AlainaWayne/AutoFeeder/README.md

# Smart Refridgerated Pet Feeder

![insert demo gif]()

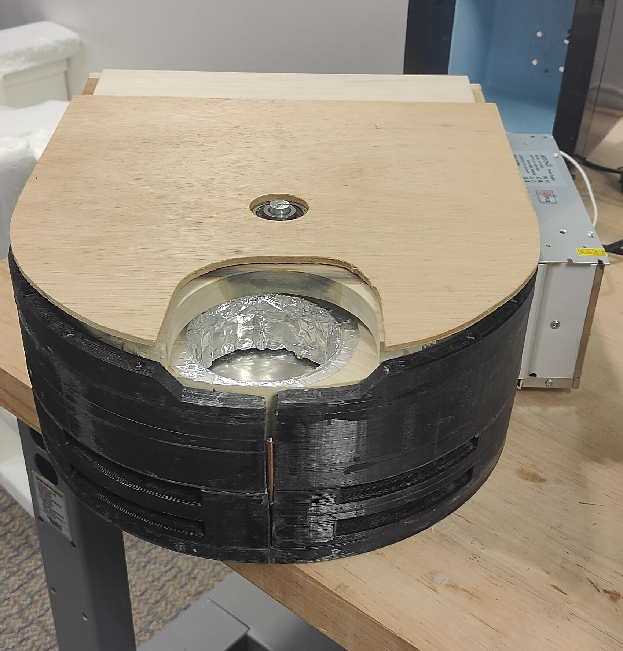
[picture p1: final_assembly_external.jpg]
Project External

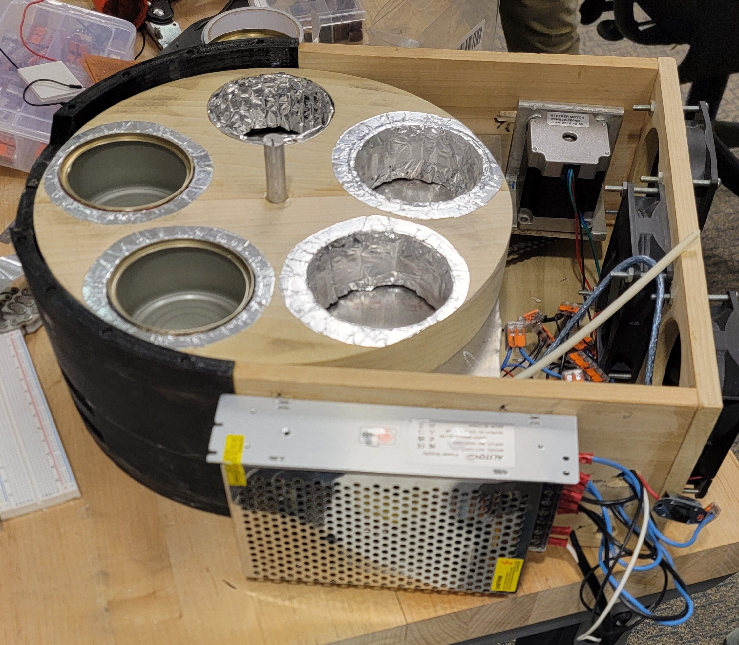
[picture p2: final_assembly_internal.jpg]
Project Internal


## Overview

The Automatic Wet Food Cat Feeder is an innovative solution to address the challenges of feeding cats on a wet food diet while the owner is away. It ensures precise portioning, maintains food freshness, and automates feeding schedules to provide convenience for pet owners and quality care for their pets.

This project was developed as part of the MECH 495 Senior Design Capstone at Kettering University.

---

## Features

- **Effective Cooling:** Maintains low temperatures to preserve wet food safety and quality
- **Accurate Dispensing:** Ensures precise rotation to dispense one portion of food at a time
- **User-Friendly Design:** Simple operation with easy refills and cleaning
- **Compact & Aesthetic:** Space-efficient and visually appealing design
- **Durable Construction:** Food-safe materials ensure long-term usability
- **Thermal Efficiency:** Isolates hot and cold zones for effective cooling
- **Cost Effective:** Designed to minimize costs
- **Future Expandability:** Designed to accommodate potential smart features

---

## Components & Materials

| Component | Quantity | Description |
|---|---|---|
| 3.5-in Fans | 3 pcs | Cooling airflow |
| Peltier Devices | 4 pcs | Thermoelectric coolers |
| Heat Sinks | 4 pcs | Heat dissipation |
| Arduino Uno Controller| 1 pc | Microcontroller |
| TB6600 Stepper Motor Driver | 1 pc | Motor control |
| Stepper Motor | 1 pc | Rotational motion |

For the complete Bill of Materials, refer to the [BOM File](https://github.com/AlainaWayne/AutomatedWetFoodFeeder/blob/main/Bill%20of%20Materials).

---

## Design Goals

1. **Reliability:** Ensures consistent feeding schedules.
2. **Power Efficiency:** Optimized for minimal power draw.
3. **Safety:** Designed with pet safety in mind.
4. **Ease of Maintenance:** Simple to disassemble for cleaning.
5. **Sustainability:** Incorporates recycled and repurposed components.

CAD Model

---

## Manufacturing Process

The feeder was crafted using a combination of CNC machining, 3D printing, and traditional woodshop techniques. Custom components were fabricated with 3D printing and aluminum sheet metal for the cooling system.

### Turntable
cat feeder turntable dimensional drawing
- The turntable was designed to hold 4 full cat food cans (enough food for 2-4 days depending on feeding schedule)
- there is an empty slot to be used as a home position when the machine is not in use

- The turntable needed to be 12 inches in diameter, but the largest stock wood we had access to was 8 inches wide
- To solve this we glued together two pices of stock material to be cut on the CNC mill

Turntable Milling
- It was milled on a Laguna IQ CNC machine

Turntable milling issue
- The stock material ended up being slightly thicker than what we designed for, so th emachine did not cut the holes all the way through
- To fix this, a hand saw was used to cut the rest of the way

Turntable

### Main Housing
- The main housing of the feeder was designed to accomodate electrical components while balancing providing sufficient insulation to keep food cold as well as evacuating heat from the hot side of the Peltier modules

#### Back Shell
- The main function of the back shell is to house the electrical components and provide a route for heat to be pulled from the system

cat feeder shell dimensional drawing
- This section of the housing was manufactured using a combination of machine tools and hand tools

- First, each panel of wood (base, 2 side walls, and back wall) we cut to the correct dimensionsions using a miter saw
- The back wall panel then had 3 circular holes, where the fans would later be attached, carefully cut out using a drill press with a hole saw attachment
- 
- 
  
- once each panel was cut, aditinal sanding using rotary, belt, and random orbital sandering tools was done to ensure that the wood was consistently smooth and minimize risk of splintering

gluing housing components
- The panels were then initially glued together using wood glue to privide strength and stability for installing wood screws

assembled wood components and fans

#### 3D Printed Air Intake Section

- The front section was designed to be 13 inches wide with symmetrical vent slots for air intake
- Due to bed size limitations of the Ender 3 Pro, the model was cut in half to be printed in two sections
- We chose to use PETG filament for its strength and thermal properites
- Each print was estimated to take about 12 hours (24 hours total) using an 8 mm nozzle

#### Lid
CNC Lid
lid assembly
fixed lid assembly
fully asseblmed lid
  
---

#### Sliding Motor Tensioning
motor tensioning
- During assembly, an issue was encountered where the motor would shift and cause the chain to loose tension over time
- This was resolved by implementing a sliding tensioning system
## Electronics

main arduino connection scematics
motor scematics
peltier scematics
hall sensor scematics

---
## Software

The plan for the code is relatively simple. Below is an outline of its structure and functionality:

### Overview

- **Constants and Variables:** All constants and variables are declared at the start to avoid confusion later.
- **Setup Routine:** All pin modes are configured in the startup routine.
- **State Machine:** The main logic is controlled by a state machine with four states:

### States

1. **WaitHome:**
   - The feeder is at the “home” position (food is not available).
   - In this state, the machine waits for input (a button in demo mode, or a timed schedule in real operation).
   - When input is received, the state transitions to `MoveFeed`.

2. **MoveFeed:**
   - The feeder moves to the next available can.
   - **Logic:**
     - Tracks which cans have been used.
     - Moves in the rotation that is fastest to reach the next available can.
   - **Tracking:**
     - Uses magnets and 2 hall effect sensors as an encoder to detect direction and position changes.
   - Once the desired can is reached, the state transitions to `WaitFeed`.

3. **WaitFeed:**
   - This state is similar to `WaitHome`.
   - The machine waits for input to indicate feeding is complete.
   - When input is received, the state transitions to `MoveHome`.

4. **MoveHome:**
   - The feeder returns to the “home” position.
   - **Logic:**
     - The current location is compared to the home position.
     - Rotates in the faster direction to return home.
   - **Tracking:**
     - An offset hall effect sensor detects a specific magnet placed at the home position.
     - When the sensor detects this magnet, the machine confirms it is in the “home” position.
   - Once home, the state transitions back to `WaitHome`.

### Summary

This state machine design ensures clear and predictable operation, handling both user input and positional accuracy.

[Link to Code](https://github.com/AlainaWayne/AutomatedWetFoodFeeder/blob/b0ec120aadc8a26be4aa09604b9c6fafe7771586/feeder_control/feeder_control.ino)

---

## Testing & Validation

### Key Tests
- **Cooling Performance:** Tested cooling rate of Peltier devices in pre-built fridge.
- **Motor Selection:** Torque calculations ensured sufficient rotation force.
- **Usability Testing:** Identified optimal height of 8 inches for maximum cat comfort.

### Results
- Cooling system reduced temperatures by 34°F over 3 hours.
- Stepper motor met torque requirements with a significant safety margin.

---

## Challenges & Solutions

- **Dimensional Adjustments:** CNC panel inaccuracies were resolved with manual corrections
- **3D Printing Challenges:** Due to 3D printer limitations, 3D printed components needed significant post-processing in order to fit properly with design
- **Chain Tensioning:** Improved by modifying motor mounting to allow tension adjustments

---

## Future Improvements

- Enhanced power efficiency
- Increased cooling capacity for prolonged food storage
- Smart integration for remote operation and monitoring
- Improved manufacturing of hardware components
- More testing is needed to determin reliablity of Peltier cooling and system operation

---

## Contributors

- Damera Gebissa
- Christian Pellerito
- Alaina Wayne
- Julia Carroll
- Jacob Morrison

---

## Acknowledgments

Special thanks to Dr. Craig Hoff and the Kettering University IME Lab for guidance and support!
