AlainaWayne/AutoFeeder/Deliverables/Bill of Materials - Pet Feeder Project (1).xlsx - Sheet1.pdf

Item | Description | Quantity | Unit Cost | Total Cost | Projected Cost Item Number | Source | Link
3.5-in Fans | Cooling Motor | 2 | $5.09 | $10.18 | $10.18 17545K63 | McMasterr-Carr https://www.mcmaster.com/catalog/130/759/17545K66 Peltier Device | Generate Power, Heating & Cooling | 4 | N/A | N/A | $86.08 9383N16 | McMasterr-Carr https://www.mcmaster.com/products/peltier-coolers/thermoelectric-modules~/ Heat Sinks | Cooling Peltier | 4 | $12.66 | $50.64 | $50.64 8822T949 | McMasterr-Carr https://www.mcmaster.com/products/heat-sinks/adhesive-mount-heat-sinks/ Wood | Frame of Turntable | 1in.x12in.x4ft. | N/A | N/A | $8.62 458503 | Home Depot | https://www.homedepot.com/p/1-in-x-12-in-x-4-ft-Pine-Common-Board-458503/100322335 Arduino Controller | Control Machine | 1 | N/A | N/A | $44.99 B01D8KOZF4 | Amazon | https://www.amazon.com/ELEGOO-Project-Tutorial-Controller-Projects/dp/B01D8KOZF4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 Motor Controller | Operate Motor | 1 | $15.95 | $15.95 | $15.95 2133 | Pololu | https://www.pololu.com/product/2133 Stepper Motor | Provide Energy | 1 | N/A | N/A | $11.00 17HS4401 | Alibaba | https://www.alibaba.com/product-detail/HANPOSE-17hs4401-1-5A-40N-cm_62449855694.html Assorted Wires | Transfer Electricity | Unknown | N/A | N/A | $5.97 | B0BRTJXND9 | Amazon | https://www.amazon.com/California-JOS-Breadboard-Optional-Multicolored/dp/B0BRTJXND9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 Assorted Foam Roll | Insulation | 6in.x550ft. | N/A | N/A | $23 S-2601 | ULINE | https://www.uline.com/BL_855/Uline-Non-Perforated-Foam-Rolls Silicon Seal | Seal | 4 | $5.83 | $23.32 | $14.72 92614 | US Plastics Co. https://www.usplastic.com/catalog/item.aspx?itemid=150353&catid=1427 RFID | Sensor | 1 | N/A | N/A | $10 CN0460 | Sunfounder | https://www.sunfounder.com/products/rfid-kit-blue Fridges | Take Peltier Components | 2 | $30 | $60 | $60 N/A | Marketplace | https://www.facebook.com/marketplace/item/2382667205407606/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 Thermalpaste | Glue High Temp Materials | 1 | $12.19 | $12.19 | $12.19 3715N11 | McMasterr-Carr https://www.mcmaster.com/catalog/130/4197/3715N11 Thermal Cutoff Switch | Turn off Heating Element | 1 | $24.59 | $24.59 | $24.59 3419N12 | McMasterr-Carr https://www.mcmaster.com/catalog/130/1169/3419N12 V-Belt | Run Turntable | 1 | $9.75 | $9.75 | $9.75 6191K16 | McMasterr-Carr https://www.mcmaster.com/products/belts/v-belts-2~/v-belts-8/ V-Belt Pulley | Run Turntable | 1 | $7.14 | $7.14 | $7.14 6245K312 | McMasterr-Carr https://www.mcmaster.com/products/belts/chain-and-belt-pulleys~/v-belt-pulleys-8/ V-Belt Pulley | Run Turntable | 1 | $9.14 | $9.14 | $9.14 6245K314 | McMasterr-Carr https://www.mcmaster.com/products/belts/chain-and-belt-pulleys~/v-belt-pulleys-8/ Dry-wall Insulation | Insulation | 1in.x4ft.x8ft. | N/A | N/A | $27.48 20WENGX | Home Depot | https://www.homedepot.com/p/Owens-Corning-FOAMULAR-NGX-F-150-1-in-x-4-ft-x-8-ft-SSE-R-5-XPS-Rigid-Foam-Board-Insulation-20WENGX/315197840 Spray foam insulation | Insulation | 16 sq. ft. | N/A | N/A | $8.40 8551K12 | McMasterr-Carr https://www.mcmaster.com/catalog/130/4049/8551K12
Items marked N/A are already owned, or being recycled from prior projects. | $222.90 | $439.74
