AlainaWayne/AutoFeeder/Manufacturing/20241104_153120.jpg

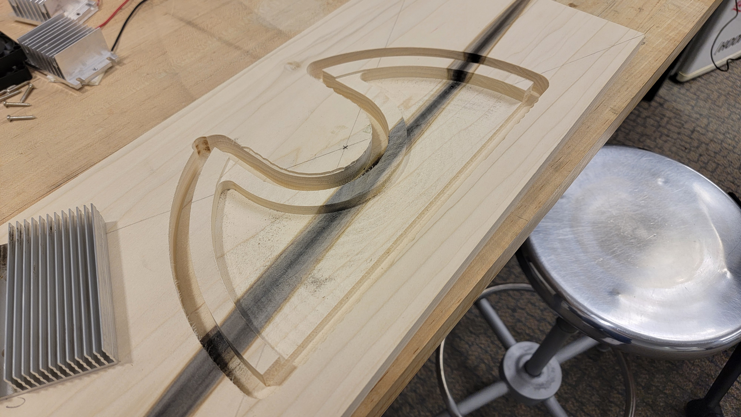
Manufacturing/20241104_153120.jpg
