AlainaWayne/AutoFeeder/Manufacturing/20241104_162909.jpg

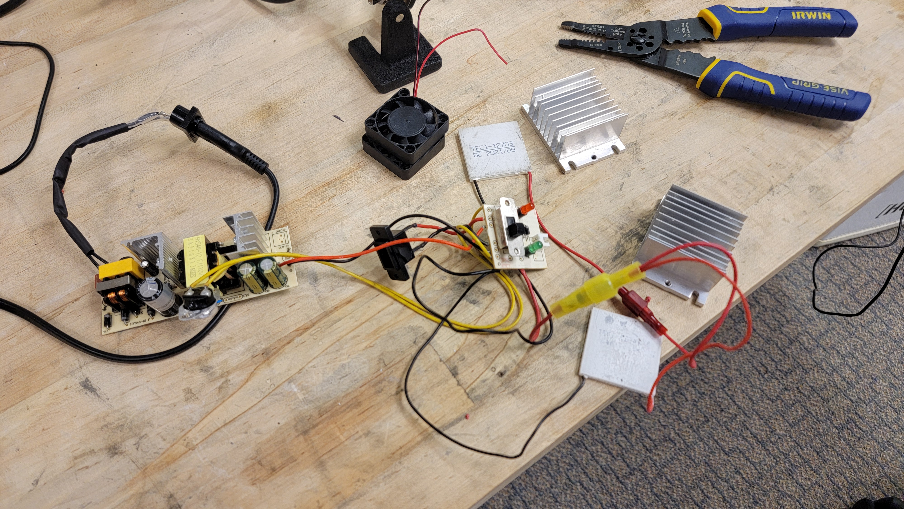
Manufacturing/20241104_162909.jpg
