AlainaWayne/AutoFeeder/Manufacturing/20241121_171549.jpg

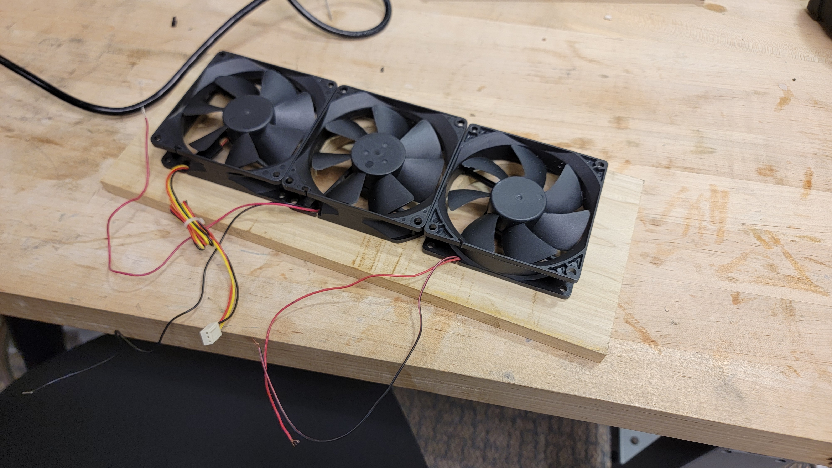
Manufacturing/20241121_171549.jpg
