AlainaWayne/AutoFeeder/Manufacturing/20241205_174115.jpg

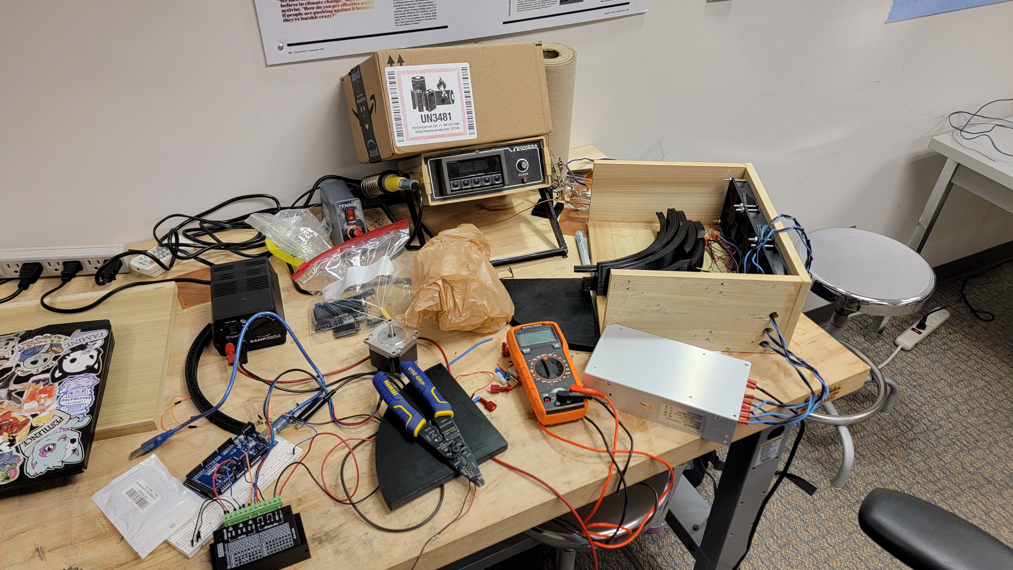
Manufacturing/20241205_174115.jpg
