AlainaWayne/AutoFeeder/Manufacturing/20241206_150830.jpg

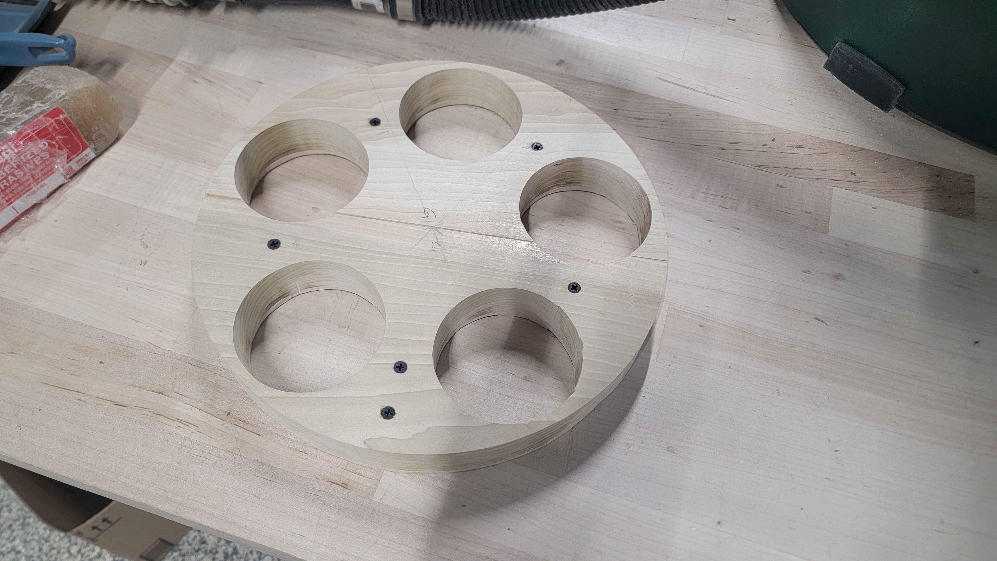
Manufacturing/20241206_150830.jpg
