AlainaWayne/AutoFeeder/Manufacturing/20241206_191830.jpg

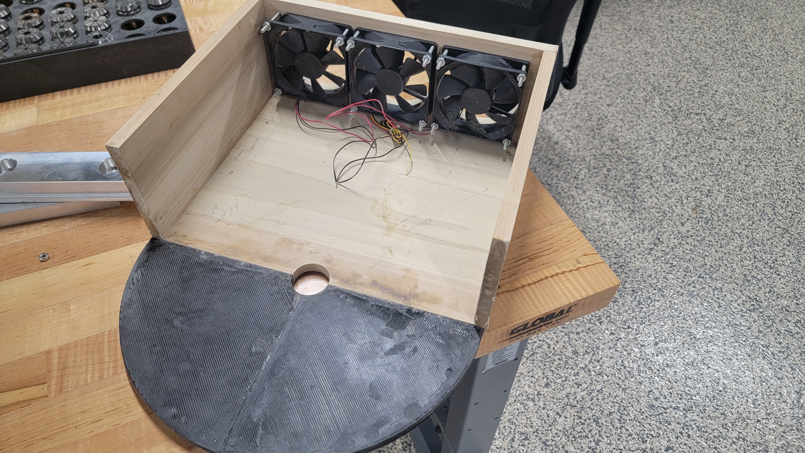
Manufacturing/20241206_191830.jpg
