AlainaWayne/AutoFeeder/Manufacturing/20241206_191835.jpg

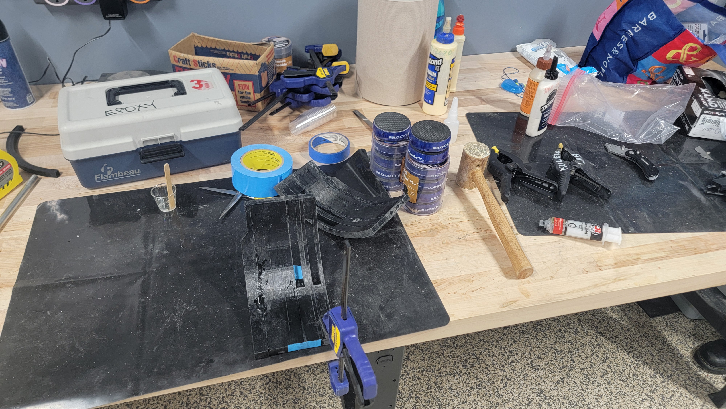
Manufacturing/20241206_191835.jpg
