AlainaWayne/AutoFeeder/Manufacturing/20241206_195926.jpg

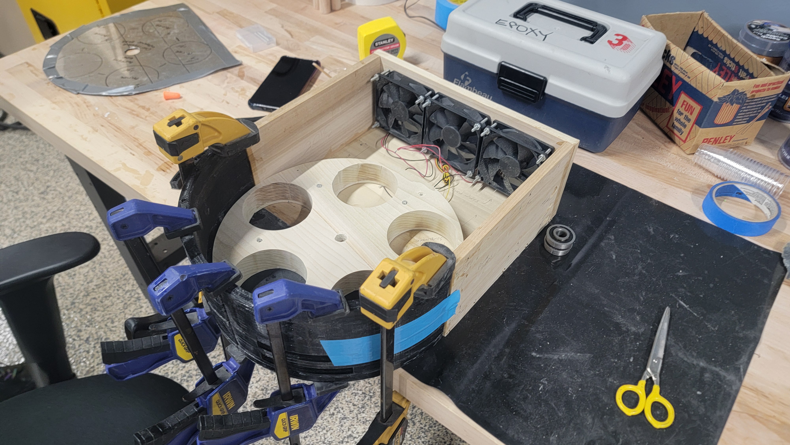
Manufacturing/20241206_195926.jpg
