AlainaWayne/AutoFeeder/Manufacturing/20241212_183925.jpg

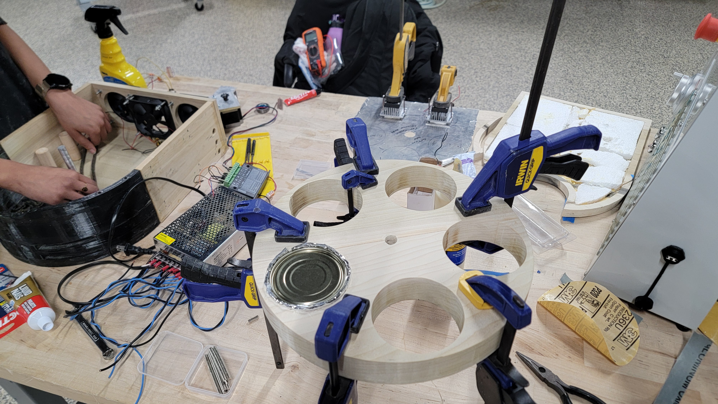
Manufacturing/20241212_183925.jpg
