AlainaWayne/AutoFeeder/Manufacturing/20241212_194303.jpg

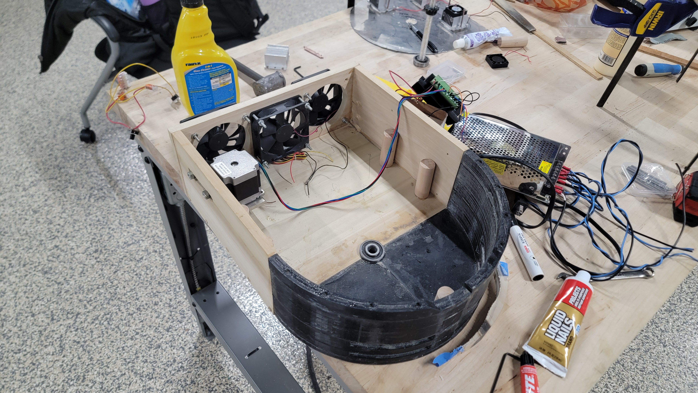
Manufacturing/20241212_194303.jpg
