AlainaWayne/AutoFeeder/Manufacturing/IMG20241106135203.jpg

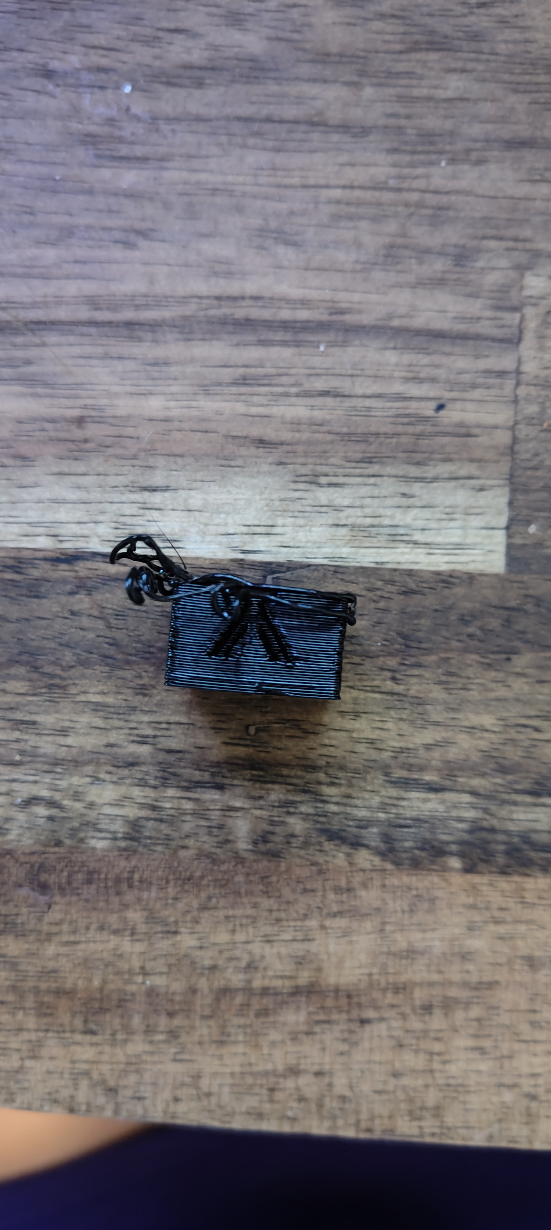
Manufacturing/IMG20241106135203.jpg
