AlainaWayne/AutoFeeder/Manufacturing/IMG20241106154316.jpg

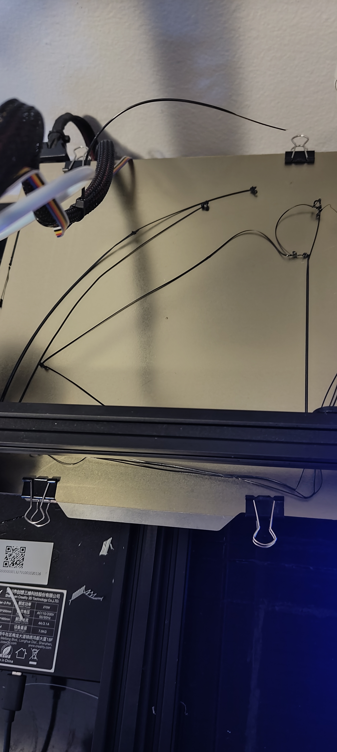
Manufacturing/IMG20241106154316.jpg
