AlainaWayne/AutoFeeder/Manufacturing/IMG20241106161655.jpg

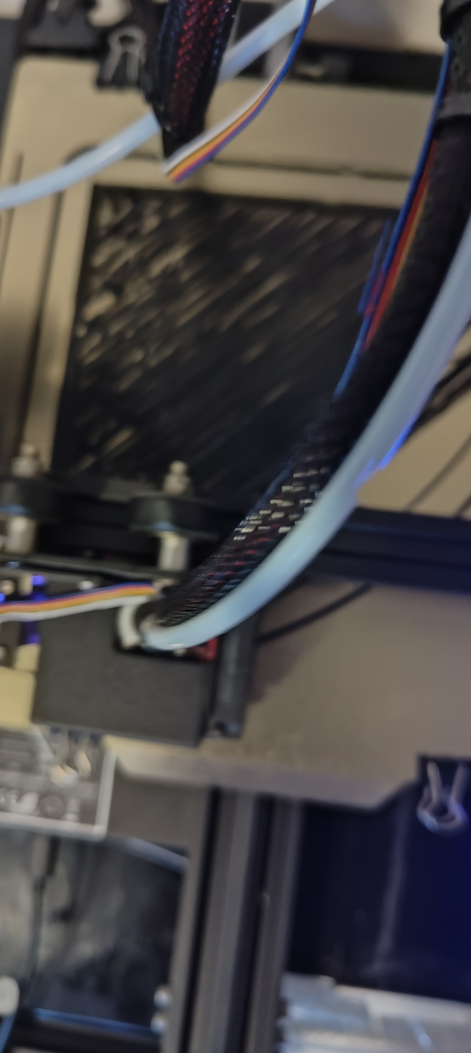
Manufacturing/IMG20241106161655.jpg
