AlainaWayne/AutoFeeder/Manufacturing/IMG20241106170730.jpg

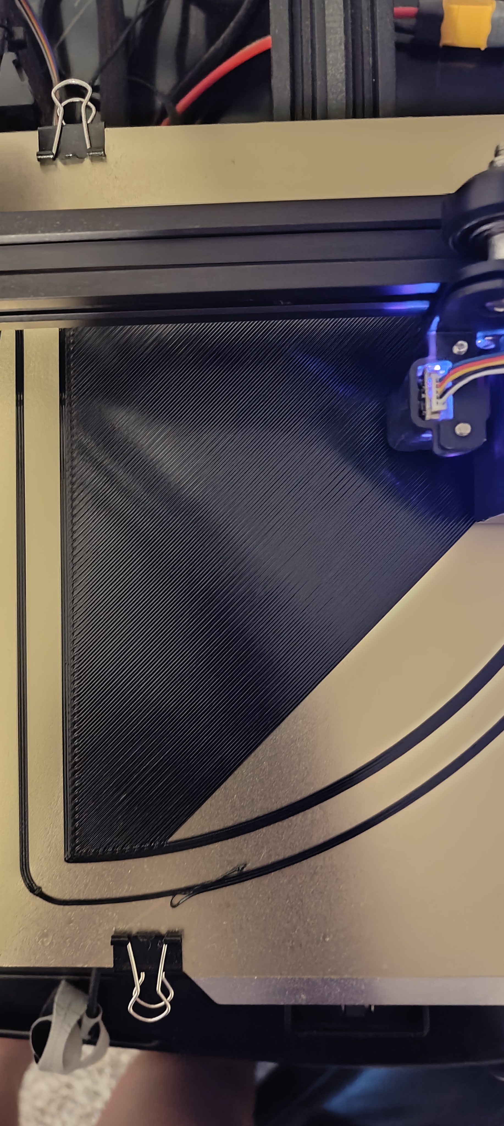
Manufacturing/IMG20241106170730.jpg
