AlainaWayne/AutoFeeder/Manufacturing/IMG20241107103250.jpg

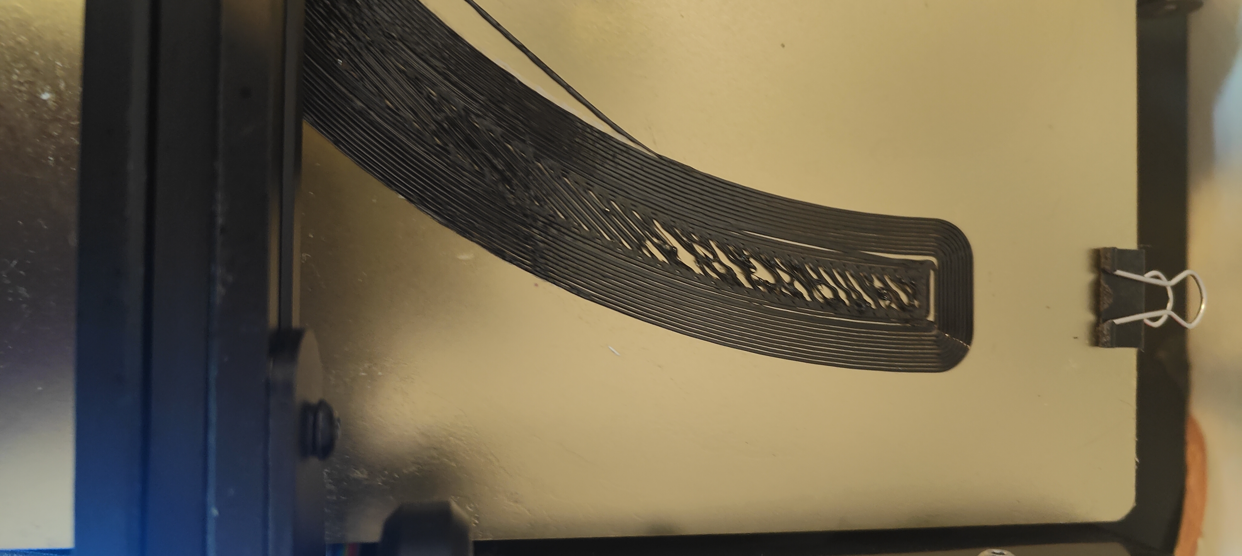
Manufacturing/IMG20241107103250.jpg
