AlainaWayne/AutoFeeder/Manufacturing/IMG20241129104141.jpg

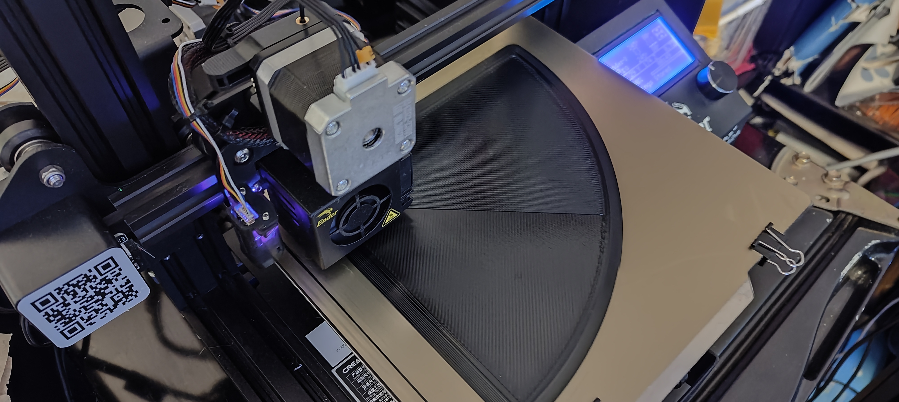
Manufacturing/IMG20241129104141.jpg
