AlainaWayne/AutoFeeder/Manufacturing/IMG20241129104142.jpg

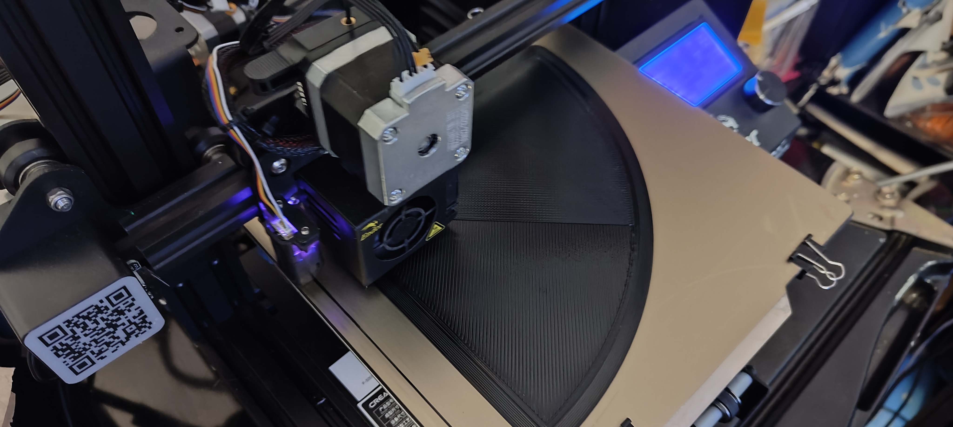
Manufacturing/IMG20241129104142.jpg
