AlainaWayne/AutoFeeder/Manufacturing/IMG20241129130520.jpg

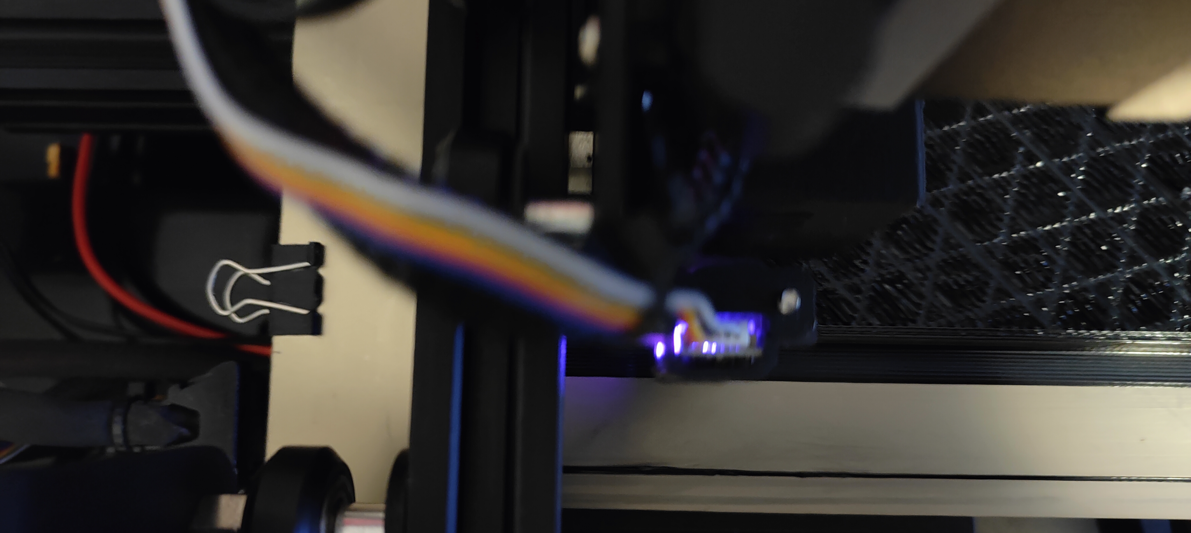
Manufacturing/IMG20241129130520.jpg
