AlainaWayne/AutoFeeder/Manufacturing/IMG20241129130526.jpg

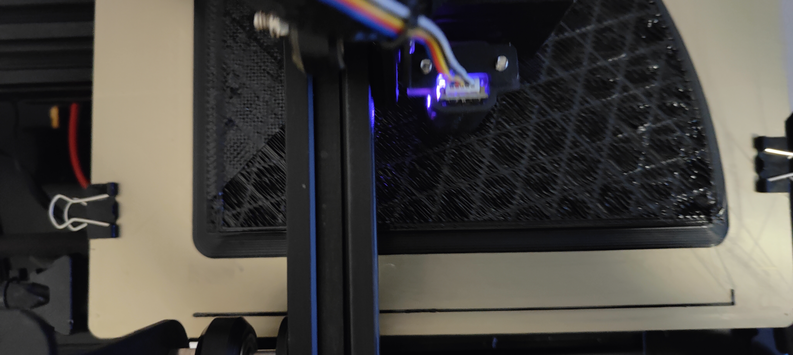
Manufacturing/IMG20241129130526.jpg
