AlainaWayne/AutoFeeder/Manufacturing/IMG20241129130749.jpg

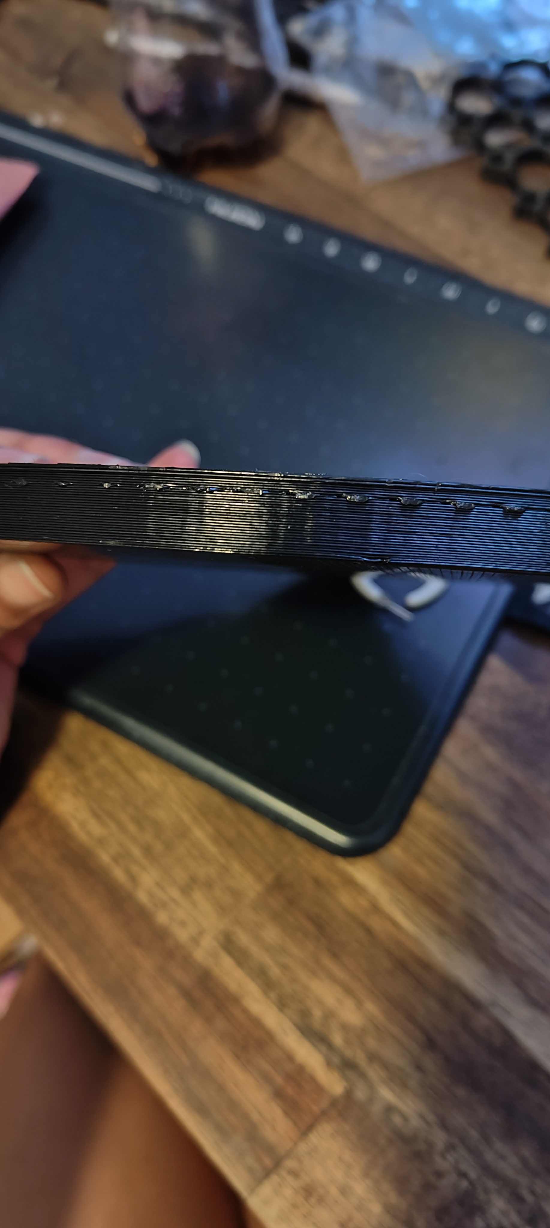
Manufacturing/IMG20241129130749.jpg
