AlainaWayne/AutoFeeder/Manufacturing/IMG20241129135219.jpg

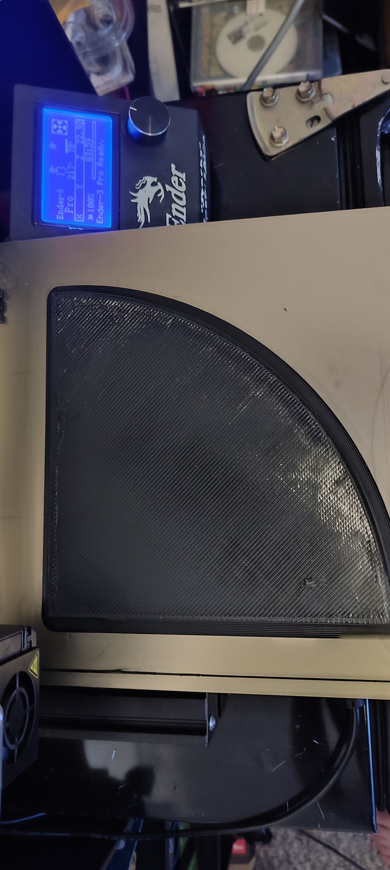
Manufacturing/IMG20241129135219.jpg
