AlainaWayne/AutoFeeder/Manufacturing/IMG20241129142711.jpg

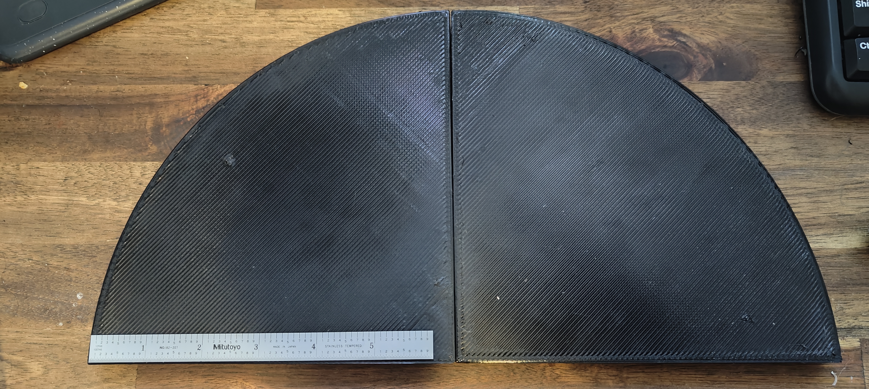
Manufacturing/IMG20241129142711.jpg
