AlainaWayne/AutoFeeder/Manufacturing/IMG20241129142724.jpg

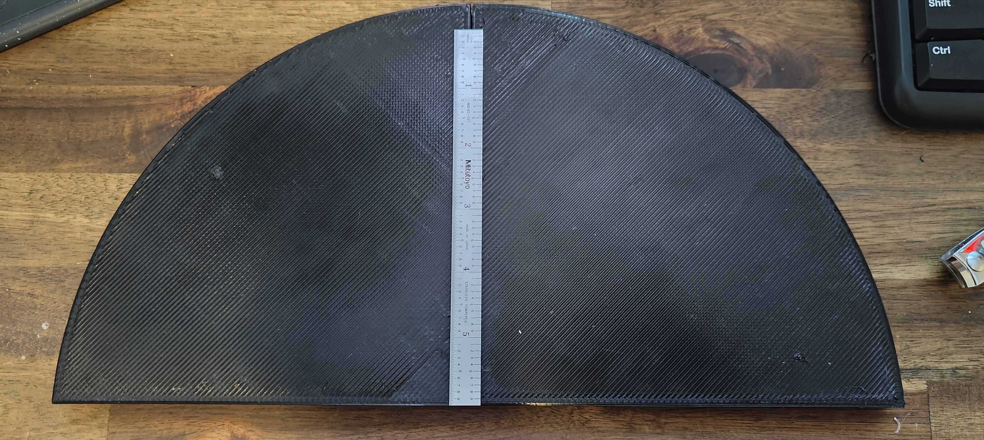
Manufacturing/IMG20241129142724.jpg
