AlainaWayne/AutoFeeder/Manufacturing/IMG20241129142733.jpg

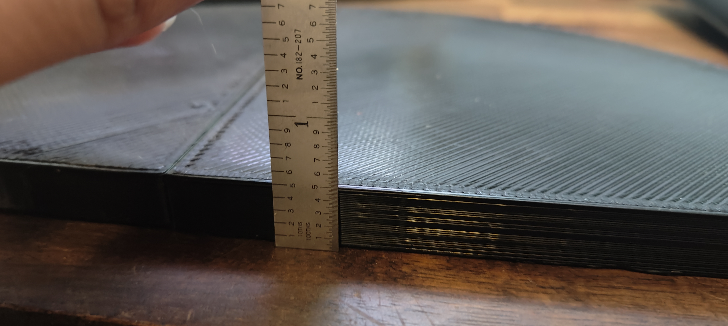
Manufacturing/IMG20241129142733.jpg
