AlainaWayne/AutoFeeder/Manufacturing/IMG20241204001852.jpg

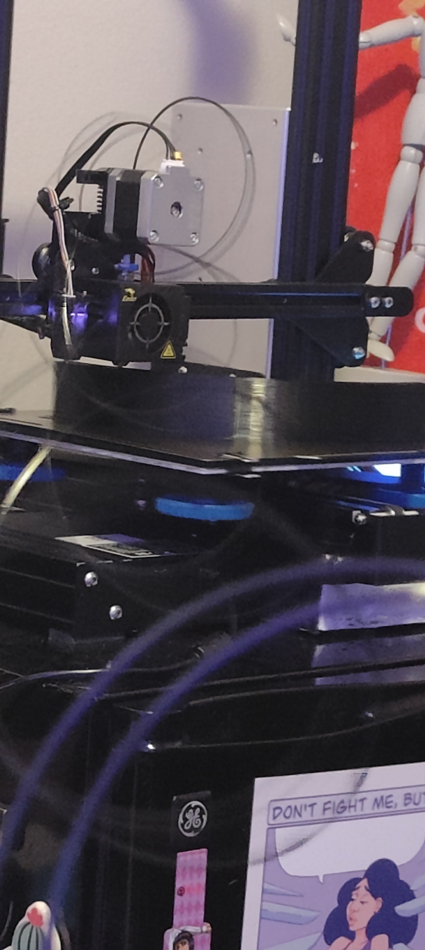
Manufacturing/IMG20241204001852.jpg
