AlainaWayne/AutoFeeder/Manufacturing/IMG20241204151253.jpg

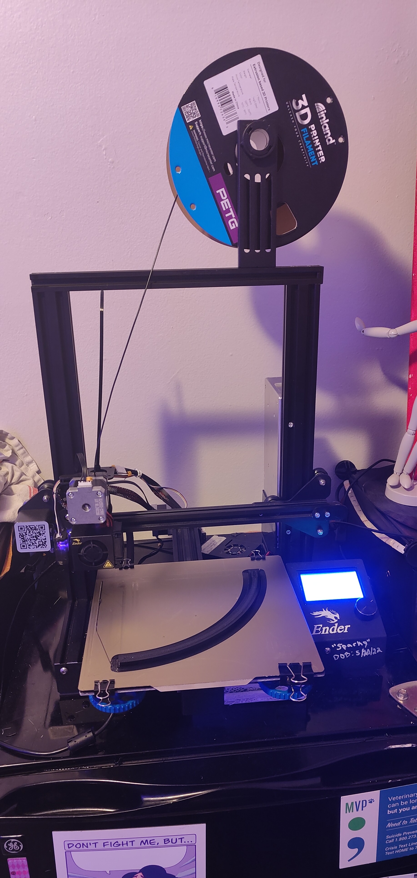
Manufacturing/IMG20241204151253.jpg
