AlainaWayne/AutoFeeder/Manufacturing/IMG20241206161430.jpg

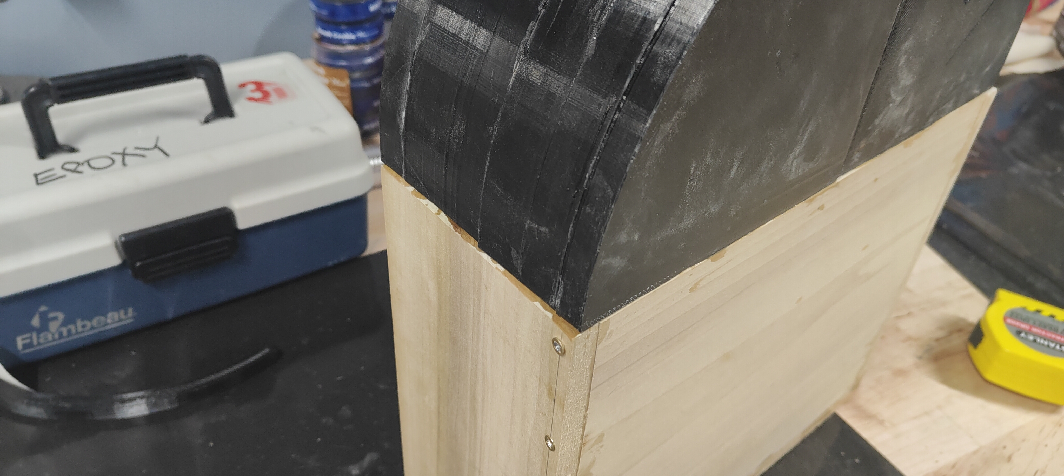
Manufacturing/IMG20241206161430.jpg
