AlainaWayne/AutoFeeder/Manufacturing/IMG20241206161432.jpg

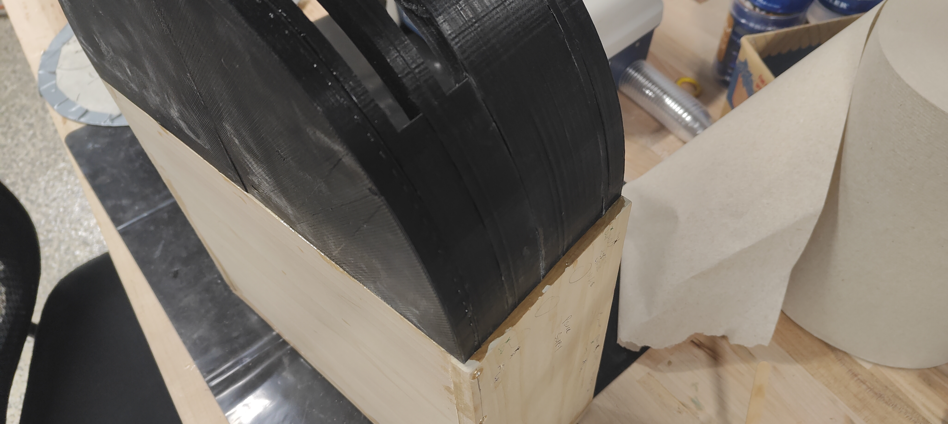
Manufacturing/IMG20241206161432.jpg
