AlainaWayne/AutoFeeder/Manufacturing/IMG20241206161435.jpg

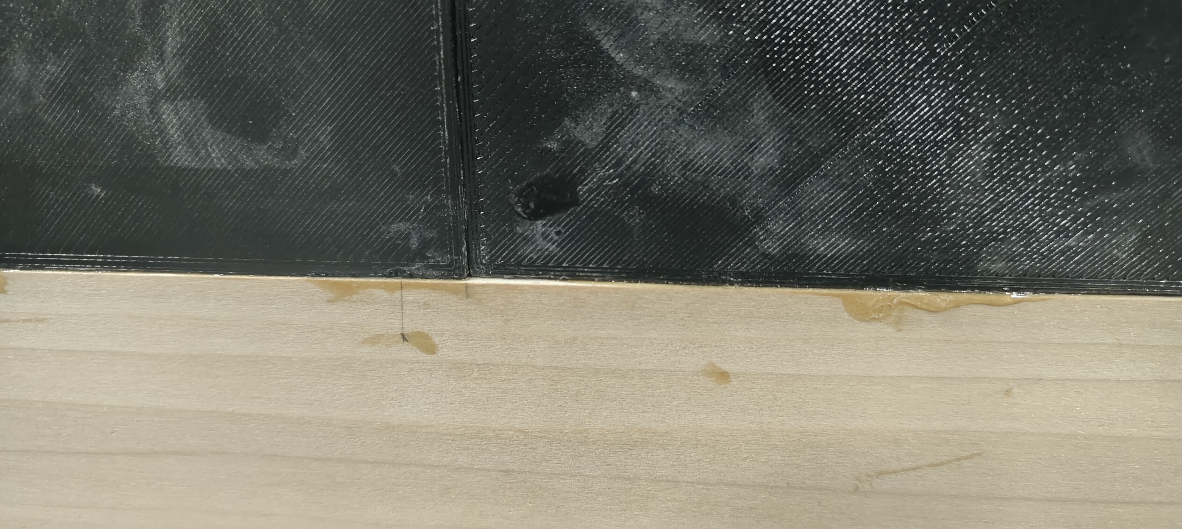
Manufacturing/IMG20241206161435.jpg
