AlainaWayne/AutoFeeder/Manufacturing/IMG20241206162558.jpg

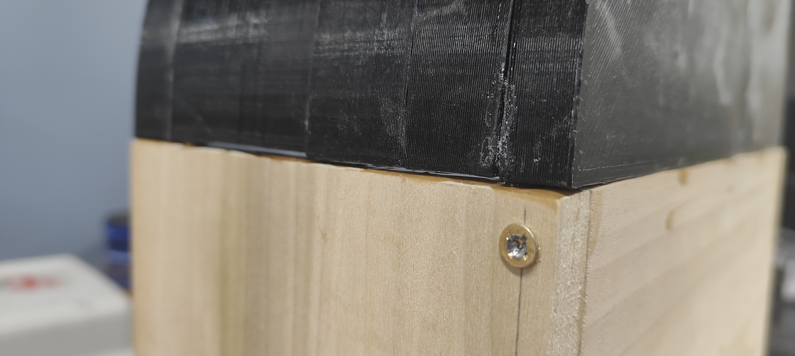
Manufacturing/IMG20241206162558.jpg
