AlainaWayne/AutoFeeder/Prototype Assembly/20241202_143242.jpg

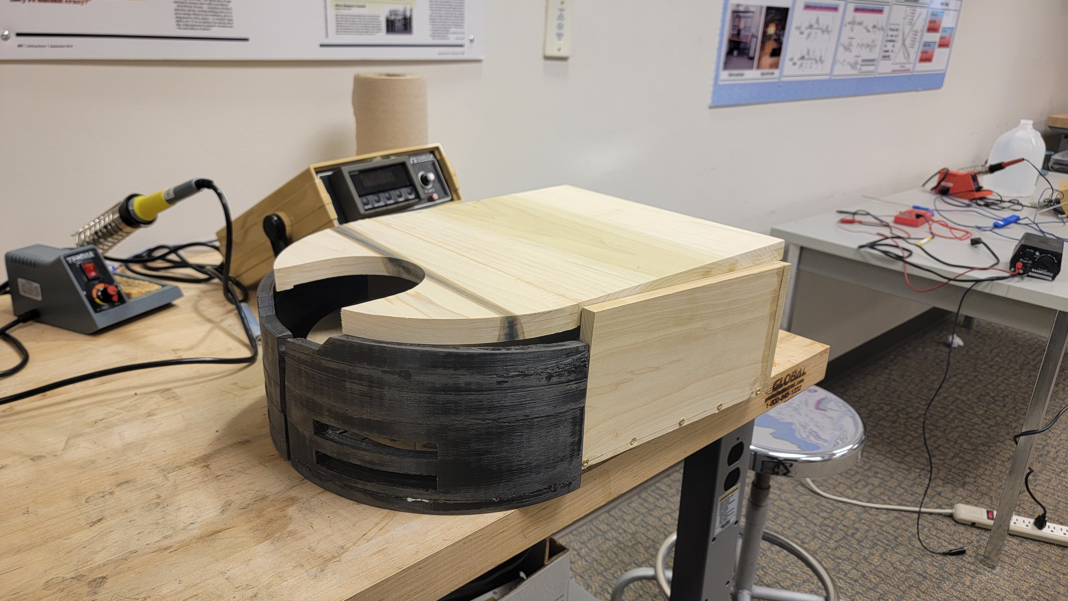
Prototype Assembly/20241202_143242.jpg
