AlainaWayne/AutoFeeder/Prototype Assembly/20241216_151222.jpg

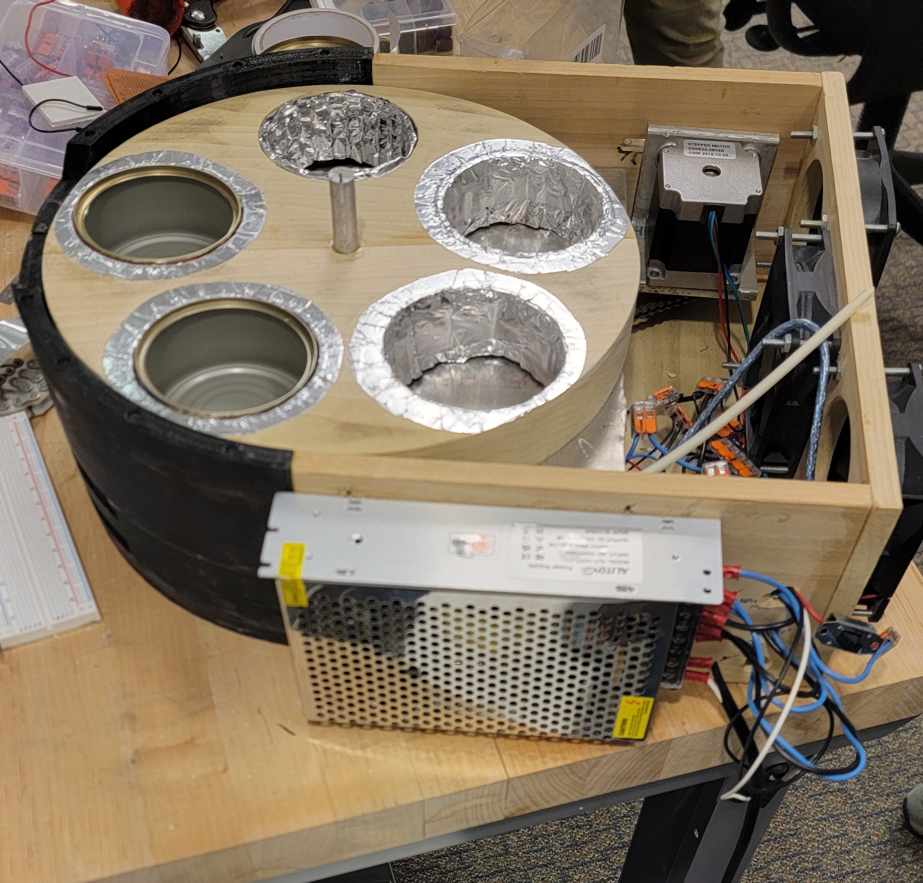
Prototype Assembly/20241216_151222.jpg
