AlainaWayne/AutoFeeder/Prototype Assembly/20241216_165430.jpg

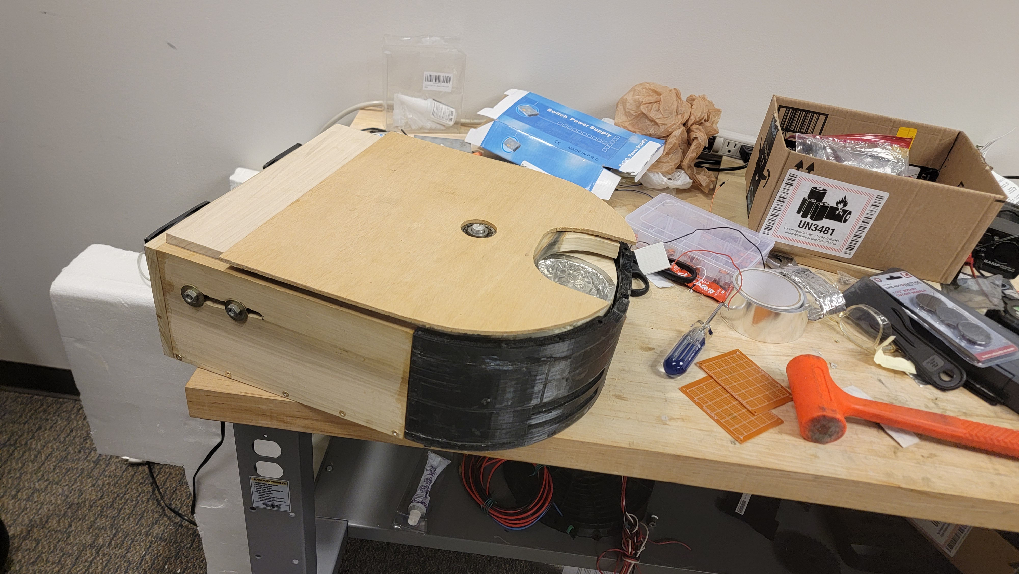
Prototype Assembly/20241216_165430.jpg
