AlainaWayne/AutoFeeder/Prototype Assembly/20241217_151036.jpg

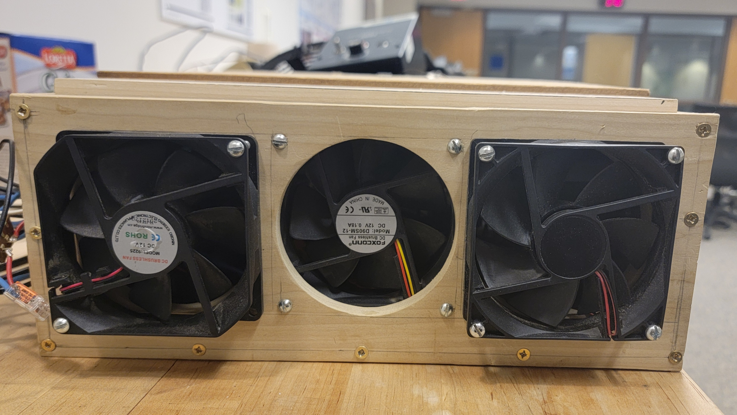
Prototype Assembly/20241217_151036.jpg
