AlainaWayne/AutoFeeder/Prototype Assembly/IMG20241216172032.jpg

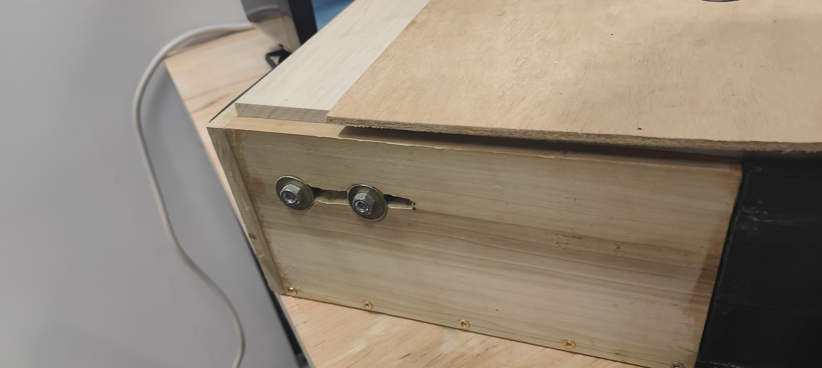
Prototype Assembly/IMG20241216172032.jpg
