AlainaWayne/AutoFeeder/(commit log)

2025-01-08 Create Bill of Materials
2025-01-08 Update README.md
    linked BOM
2025-01-08 Rename Final Product/20241202_143242.jpg to Prototype Assembly
2025-01-08 Add files via upload
    Arduino code
